Jose-WaitNRest/PCB-Cuarto/PCB/PCB-Cuarto.kicad_pcb

## KiCad design PCB/PCB-Cuarto.kicad_pcb (2026-04-22)

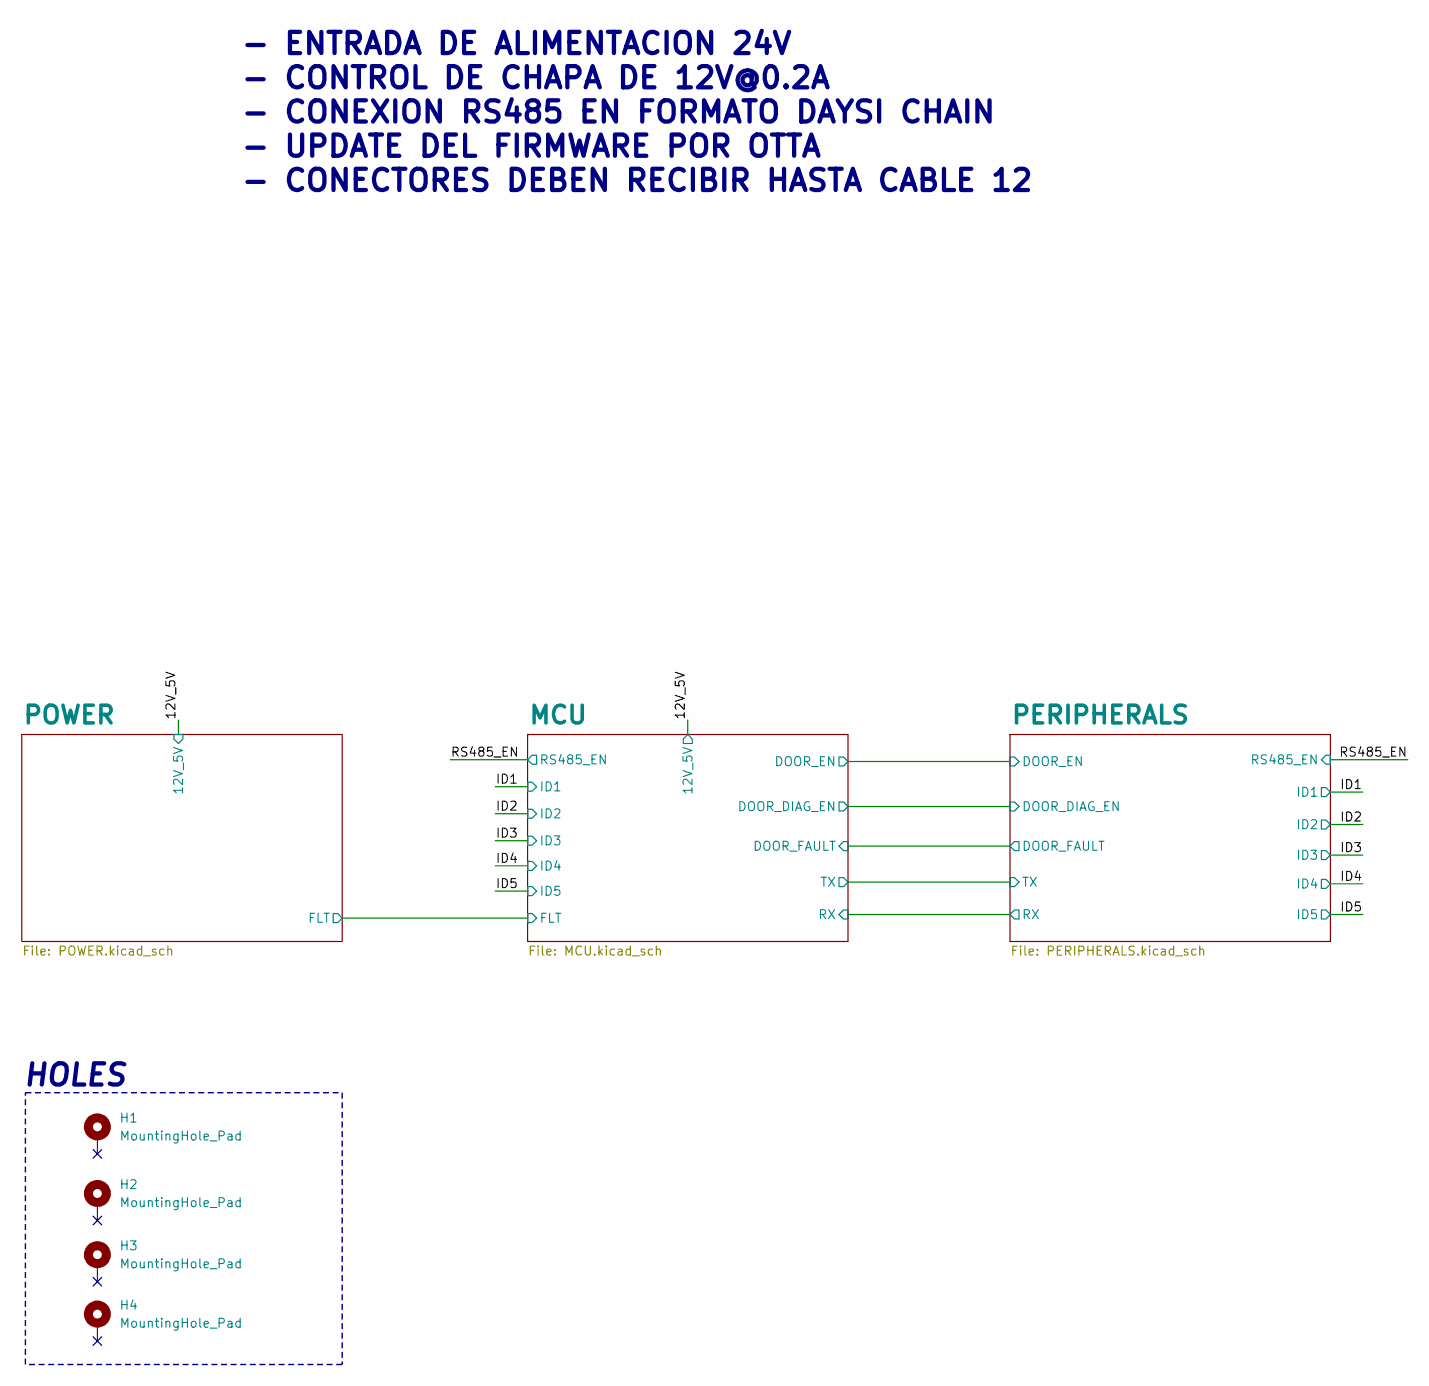
[picture p1: schematic PCB-Cuarto.kicad_sch]

Parts:
H1, H2, H3, H4: MountingHole_Pad; MountingHole_3.5mm_Pad_Via

Notes on the sheet:
- ENTRADA DE ALIMENTACION 24V - CONTROL DE CHAPA DE 12V@0.2A - CONEXION RS485 EN FORMATO DAYSI CHAIN - UPDATE DEL FIRMWARE POR OTTA - CONECTORES DEBEN RECIBIR HASTA CABLE 12
HOLES

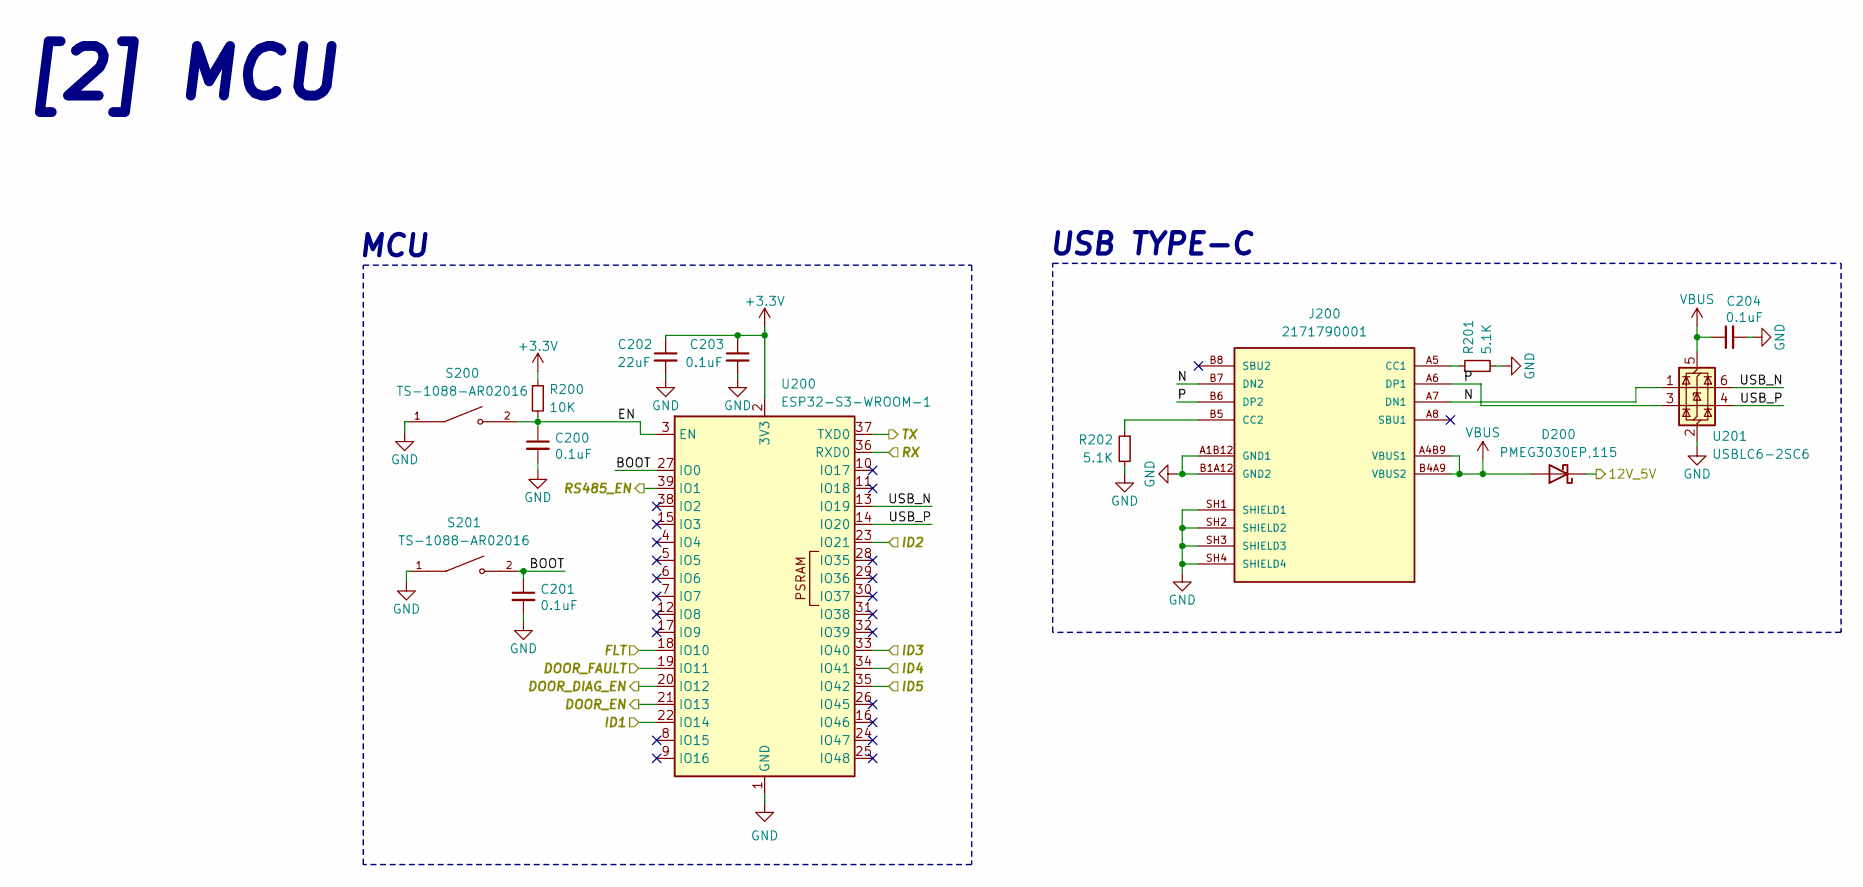
[picture p2: schematic MCU.kicad_sch]

Parts:
C200, C201, C203, C204: 0.1uF; C_0603_1608Metric_Pad1.08x0.95mm_HandSolder; LCSC C14663
C202: 22uF; C_0603_1608Metric_Pad1.08x0.95mm_HandSolder; LCSC C86295
D200: PMEG3030EP,115; D_SOD-128; LCSC C255587
J200: 2171790001; MOLEX_2171790001; LCSC C3197684
R200: 10K; R_0603_1608Metric; LCSC C25804
R201, R202: 5.1K; R_0603_1608Metric; LCSC C23186
S200, S201: TS-1088-AR02016; LCSC C720477
U200: ESP32-S3-WROOM-1; LCSC C2913202
U201: USBLC6-2SC6; SOT-23-6

Connections:
+3.3V: C202.1, C203.1, R200.1, U200.2 (3V3); also elsewhere on the board
/12V_5V: D200.1 (K); also elsewhere on the board
/ID1: U200.22 (IO14); also elsewhere on the board
/ID2: U200.23 (IO21); also elsewhere on the board
/ID3: U200.33 (IO40); also elsewhere on the board
/ID4: U200.34 (IO41); also elsewhere on the board
/ID5: U200.35 (IO42); also elsewhere on the board
/MCU/BOOT: C201.1, S201.2, U200.27 (IO0)
/MCU/DOOR_DIAG_EN: U200.20 (IO12); also elsewhere on the board
/MCU/DOOR_EN: U200.21 (IO13); also elsewhere on the board
/MCU/DOOR_FAULT: U200.19 (IO11); also elsewhere on the board
/MCU/EN: C200.1, R200.2, S200.2, U200.3 (EN)
/MCU/FLT: U200.18 (IO10); also elsewhere on the board
/MCU/N: J200.A7 (DN1), J200.B7 (DN2), U201.1 (I/O1)
/MCU/P: J200.A6 (DP1), J200.B6 (DP2), U201.3 (I/O2)
/MCU/RX: U200.36 (RXD0); also elsewhere on the board
/MCU/TX: U200.37 (TXD0); also elsewhere on the board
/MCU/USB_N: U200.13 (IO19), U201.6 (I/O1)
/MCU/USB_P: U200.14 (IO20), U201.4 (I/O2)
/RS485_EN: U200.39 (IO1); also elsewhere on the board
GND: C200.2, C201.2, C202.2, C203.2, C204.2, J200.A1B12 (GND1), J200.B1A12 (GND2), J200.SH1 (SHIELD1), J200.SH2 (SHIELD2), J200.SH3 (SHIELD3), J200.SH4 (SHIELD4), R201.2, R202.2, S200.1, S201.1, U200.1 (GND), U200.40 (GND), U200.41 (GND), U201.2 (GND); also elsewhere on the board
unnamed: J200.A5 (CC1), R201.1
unnamed: J200.B5 (CC2), R202.1
VBUS: C204.1, D200.2 (A), J200.A4B9 (VBUS1), J200.B4A9 (VBUS2), U201.5 (VBUS)

Notes on the sheet:
USB TYPE-C
[2] MCU
MCU

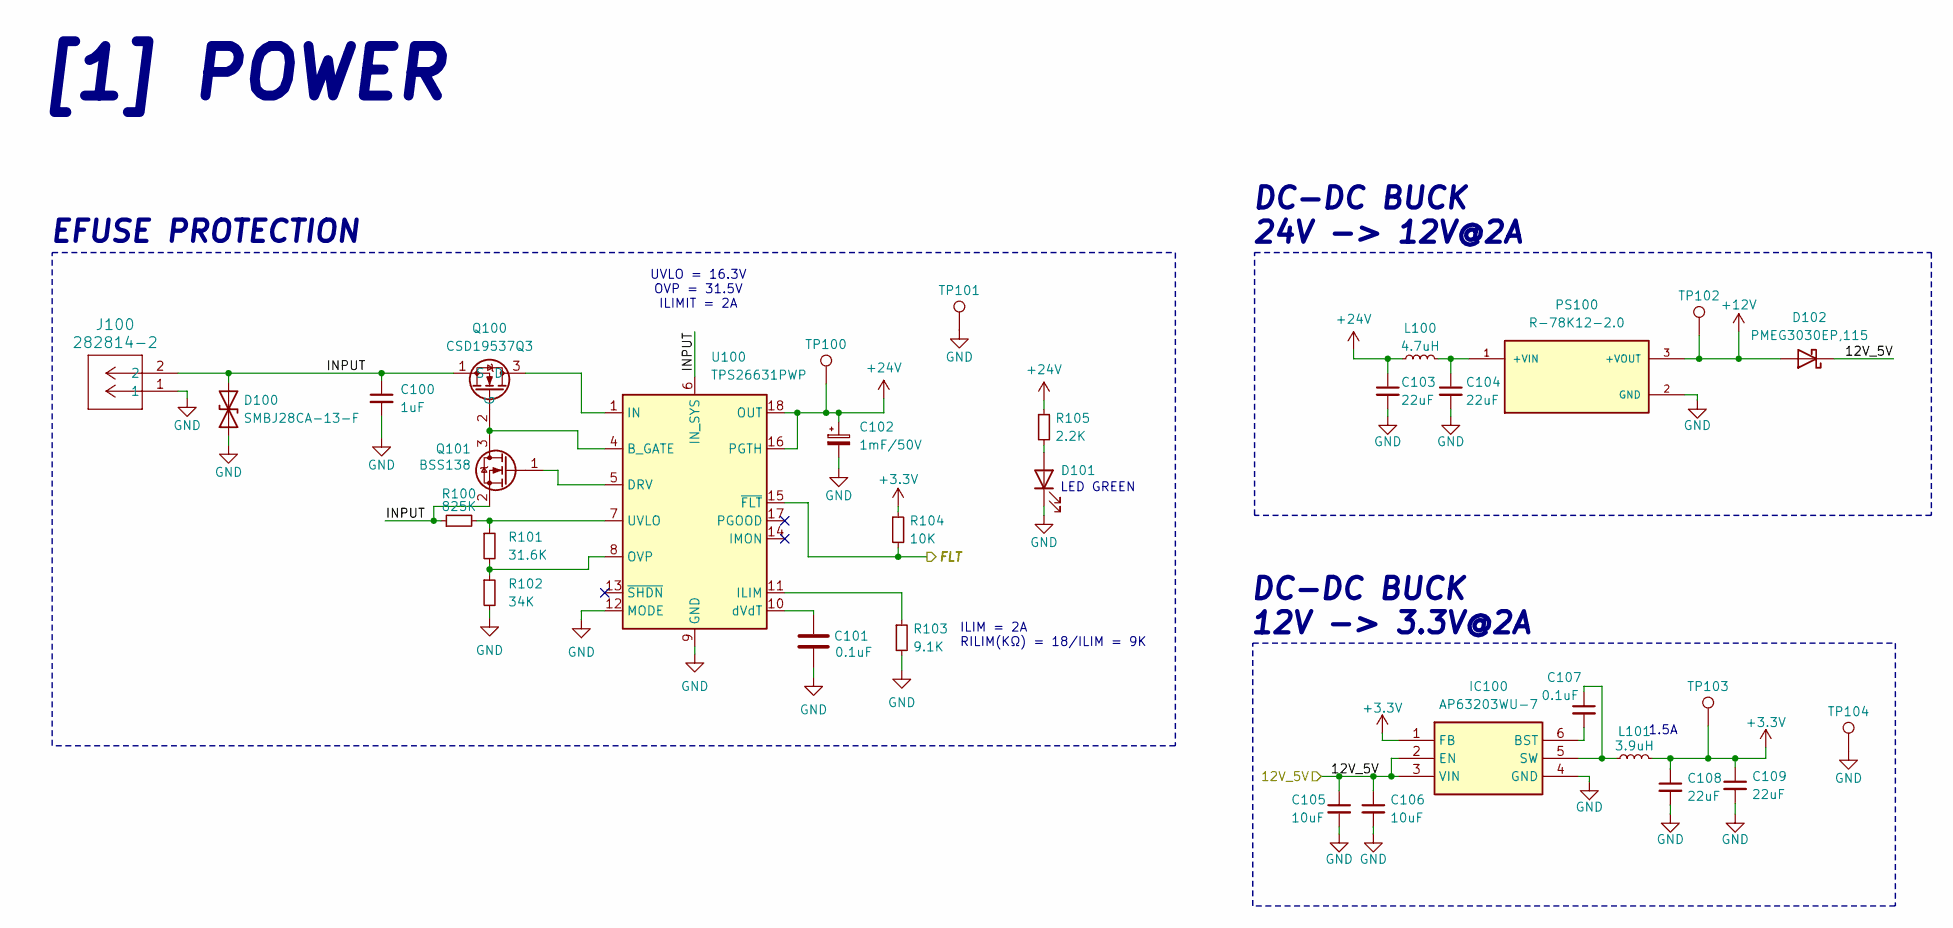
[picture p3: schematic POWER.kicad_sch]

Parts:
C100: 1uF; C_1206_3216Metric_Pad1.33x1.80mm_HandSolder; LCSC C1848
C101: 0.1uF; C_0603_1608Metric; LCSC C14663
C102: 1mF/50V; VKMI1701H102MV; LCSC C487374
C103, C104: 22uF; C_1206_3216Metric; LCSC C342620
C105, C106: 10uF; C_0805_2012Metric_Pad1.18x1.45mm_HandSolder; LCSC C440198
C107: 0.1uF; C_0603_1608Metric_Pad1.08x0.95mm_HandSolder; LCSC C14663
C108, C109: 22uF; C_0603_1608Metric_Pad1.08x0.95mm_HandSolder; LCSC C86295
D100: SMBJ28CA-13-F; D_SMB; LCSC C135064
D101: 19-21/GHC-YR1S2/4T; LED_0603_1608Metric; LCSC C2986048
D102: PMEG3030EP,115; D_SOD-128; LCSC C255587
IC100: AP63203WU-7; AP63203WU7; LCSC C780769
J100: 282814-2; LCSC C5187973
L100: 4.7uH; MDA5030-4R7M; LCSC C2847477
L101: 3.9uH; L_Sunlord_SWPA4030S; LCSC C96899
PS100: R-78K12-2.0; R-78K12-2_0; PARTREV 0/2023
Q100: CSD19537Q3; Mouser Part Number 595-CSD19537Q3
Q101: BSS138; SOT-23; LCSC C40912
R100: 825K; R_0805_2012Metric; LCSC C49010125
R101: 31.6K; R_0603_1608Metric; LCSC C25967
R102: 34K; R_0603_1608Metric; LCSC C23008
R103: 9.1K; R_0603_1608Metric; LCSC C23260
R104: 10K; R_0603_1608Metric; LCSC C25804
R105: 2.2K; R_0603_1608Metric; LCSC C4190
TP100, TP101, TP102, TP103, TP104: TestPoint; TestPoint_Pad_D2.0mm
U100: TPS26631PWP; HTSSOP-20-1EP_4.4x6.5mm_P0.65mm_EP3.4x6.5mm_Mask2.96x2.96mm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; LCSC C2832195

Connections:
+3.3V: C108.1, C109.1, IC100.1 (FB), L101.2, R104.1, TP103.1; also elsewhere on the board
+12V: D102.2 (A), PS100.3 (+VOUT), TP102.1; also elsewhere on the board
+24V: C102.1, C103.1, L100.1, R105.1, TP100.1, U100.16 (PGTH), U100.18 (OUT), U100.19 (OUT), U100.20 (OUT)
/12V_5V: C105.1, C106.1, D102.1 (K), IC100.2 (EN), IC100.3 (VIN); also elsewhere on the board
/MCU/FLT: R104.2, U100.15 (~FLT); also elsewhere on the board
/POWER/INPUT: C100.1, D100.2 (A2), J100.2, Q100.1 (S), Q101.2 (S), R100.1, U100.6 (IN_SYS)
GND: C100.2, C101.1, C102.2, C103.2, C104.2, C105.2, C106.2, C108.2, C109.2, D100.1 (A1), D101.1 (K), IC100.4 (GND), J100.1, PS100.2 (GND), R102.2, R103.2, TP101.1, TP104.1, U100.9 (GND), U100.12 (MODE), U100.21 (GND); also elsewhere on the board
unnamed: D101.2 (A), R105.2
unnamed: C107.2, IC100.6 (BST)
unnamed: C107.1, IC100.5 (SW), L101.1
unnamed: C104.1, L100.2, PS100.1 (+VIN)
unnamed: Q100.3 (D), U100.1 (IN), U100.2 (IN), U100.3 (IN)
unnamed: Q100.2 (G), Q101.3 (D), U100.4 (B_GATE)
unnamed: Q101.1 (G), U100.5 (DRV)
unnamed: R103.1, U100.11 (ILIM)
unnamed: R101.2, R102.1, U100.8 (OVP)
unnamed: R100.2, R101.1, U100.7 (UVLO)
unnamed: C101.2, U100.10 (dVdT)

Notes on the sheet:
[1] POWER
DC-DC BUCK 24V -> 12V@2A
DC-DC BUCK 12V -> 3.3V@2A
LED GREEN
UVLO = 16.3V OVP = 31.5V ILIMIT = 2A
EFUSE PROTECTION
ILIM = 2A RILIM(KΩ) = 18/ILIM = 9K
1.5A

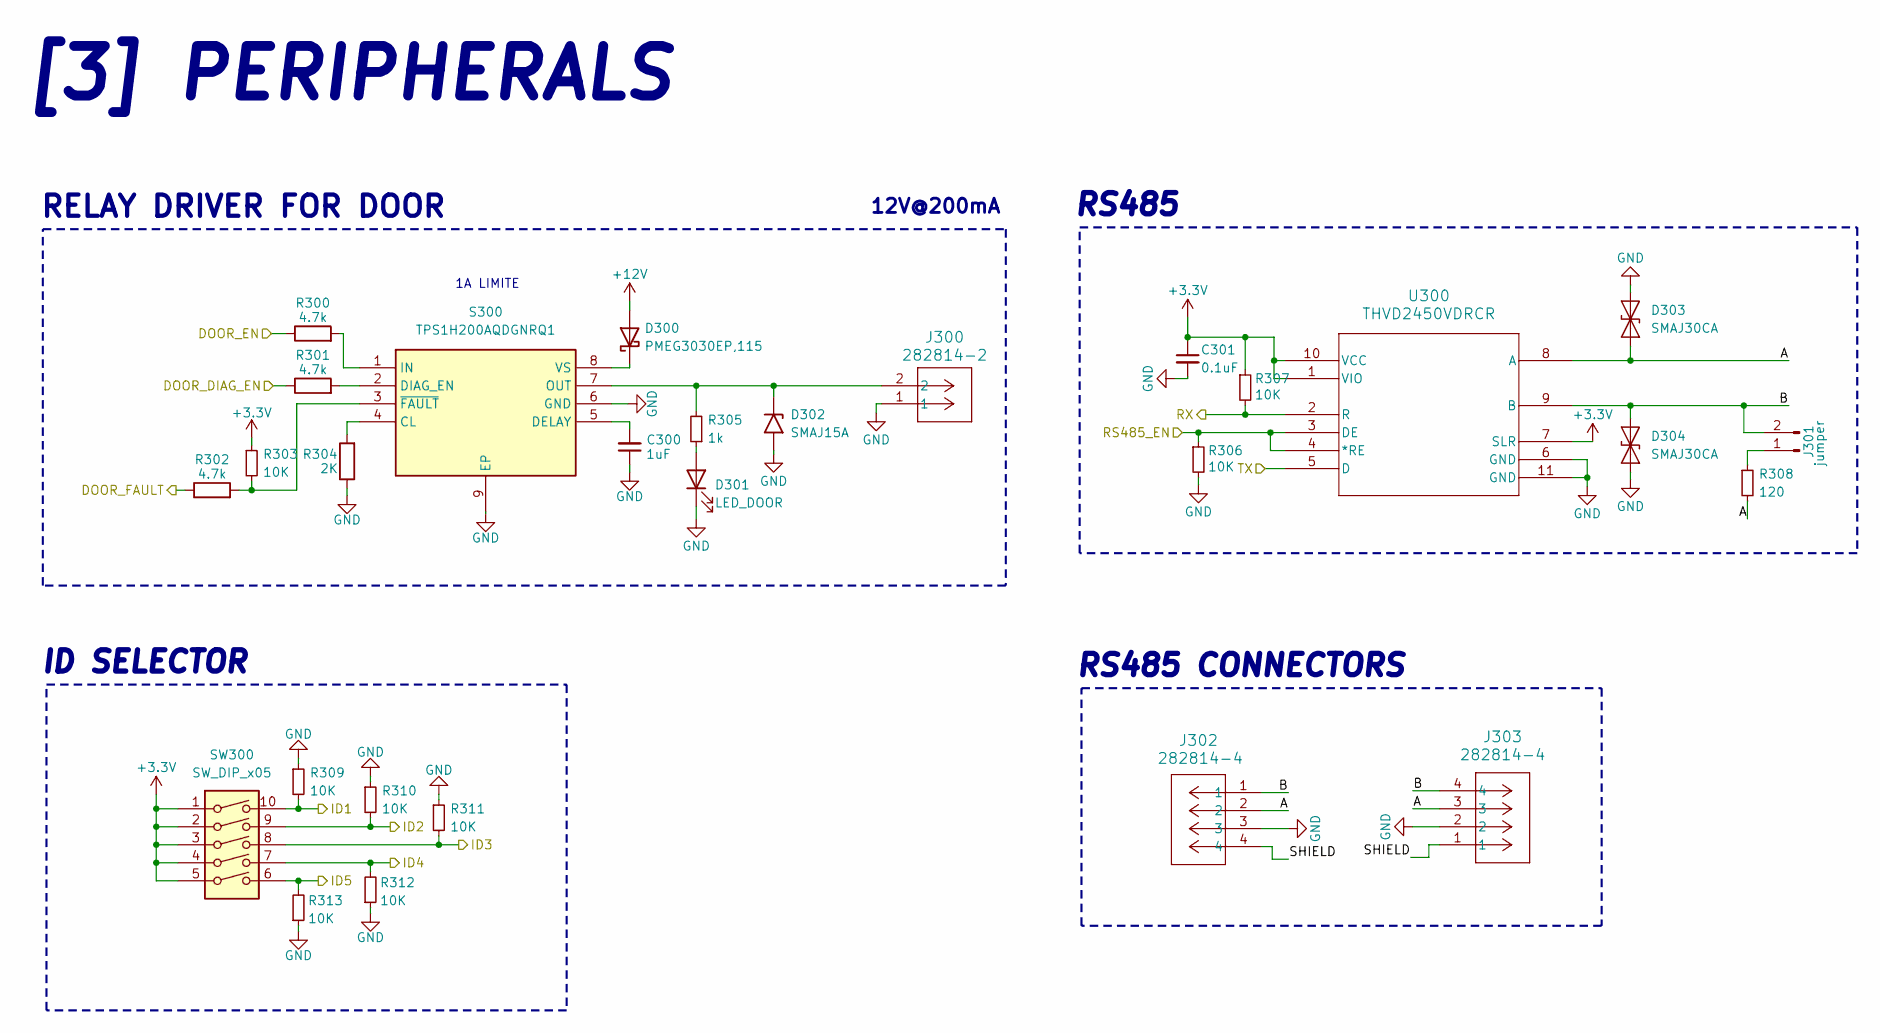
[picture p4: schematic PERIPHERALS.kicad_sch]

Parts:
C300: 1uF; C_0603_1608Metric_Pad1.08x0.95mm_HandSolder; LCSC C15849
C301: 0.1uF; C_0603_1608Metric; LCSC C14663
D300: PMEG3030EP,115; D_SOD-128; LCSC C255587
D301: LED_DOOR; LED_0603_1608Metric; LCSC C72038
D302: SMAJ15A; D_SMA; LCSC C110520
D303, D304: SMAJ30CA; D_SMA; LCSC C83322
J300: 282814-2; LCSC C5187973
J301: jumper; PinHeader_1x02_P2.54mm_Vertical; LCSC C492401
J302, J303: 282814-4; LCSC C5187975
R300, R301, R302: 4.7k; R_0603_1608Metric; LCSC C23162
R303, R306, R307, R309, R310, R311, R312, R313: 10K; R_0603_1608Metric; LCSC C25804
R304: 2K; R_0603_1608Metric; LCSC C22975
R305: 1k; R_0603_1608Metric; LCSC C21190
R308: 120; R_0603_1608Metric; LCSC C22787
S300: TPS1H200AQDGNRQ1; SOP65P490X110-9N; LCSC C2653785
SW300: SW_DIP_x05; DSIC-05-LS-GER; LCSC C7471367
U300: THVD2450VDRCR; VSON10_DRC_TEX; LCSC C5960705

Connections:
+3.3V: C301.1, R303.1, R307.1, SW300.1, SW300.2, SW300.3, SW300.4, SW300.5, U300.1 (VIO), U300.7 (SLR), U300.10 (VCC); also elsewhere on the board
+12V: D300.2 (A); also elsewhere on the board
/ID1: R309.2, SW300.10; also elsewhere on the board
/ID2: R310.2, SW300.9; also elsewhere on the board
/ID3: R311.2, SW300.8; also elsewhere on the board
/ID4: R312.2, SW300.7; also elsewhere on the board
/ID5: R313.2, SW300.6; also elsewhere on the board
/MCU/DOOR_DIAG_EN: R301.1; also elsewhere on the board
/MCU/DOOR_EN: R300.1; also elsewhere on the board
/MCU/DOOR_FAULT: R302.1; also elsewhere on the board
/MCU/RX: R307.2, U300.2 (R); also elsewhere on the board
/MCU/TX: U300.5 (D); also elsewhere on the board
/PERIPHERALS/A: D303.2 (A2), J302.2, J303.3, R308.2, U300.8 (A)
/PERIPHERALS/B: D304.2 (A2), J301.2, J302.1, J303.4, U300.9 (B)
/PERIPHERALS/SHIELD: J302.4, J303.1
/RS485_EN: R306.1, U300.3 (DE), U300.4 (*RE); also elsewhere on the board
GND: C300.1, C301.2, D301.1 (K), D302.2 (A2), D303.1 (A1), D304.1 (A1), J300.1, J302.3, J303.2, R304.1, R306.2, R309.1, R310.1, R311.1, R312.1, R313.1, S300.6 (GND), S300.9 (EP), U300.6 (GND), U300.11 (GND); also elsewhere on the board
unnamed: D300.1 (K), S300.8 (VS)
unnamed: D301.2 (A), R305.1
unnamed: D302.1 (A1), J300.2, R305.2, S300.7 (OUT)
unnamed: J301.1, R308.1
unnamed: R304.2, S300.4 (CL)
unnamed: C300.2, S300.5 (DELAY)
unnamed: R301.2, S300.2 (DIAG_EN)
unnamed: R300.2, S300.1 (IN)
unnamed: R302.2, R303.2, S300.3 (~FAULT)

Notes on the sheet:
ID SELECTOR
RS485 CONNECTORS
RELAY DRIVER FOR DOOR
[3] PERIPHERALS
1A LIMITE
12V@200mA
RS485

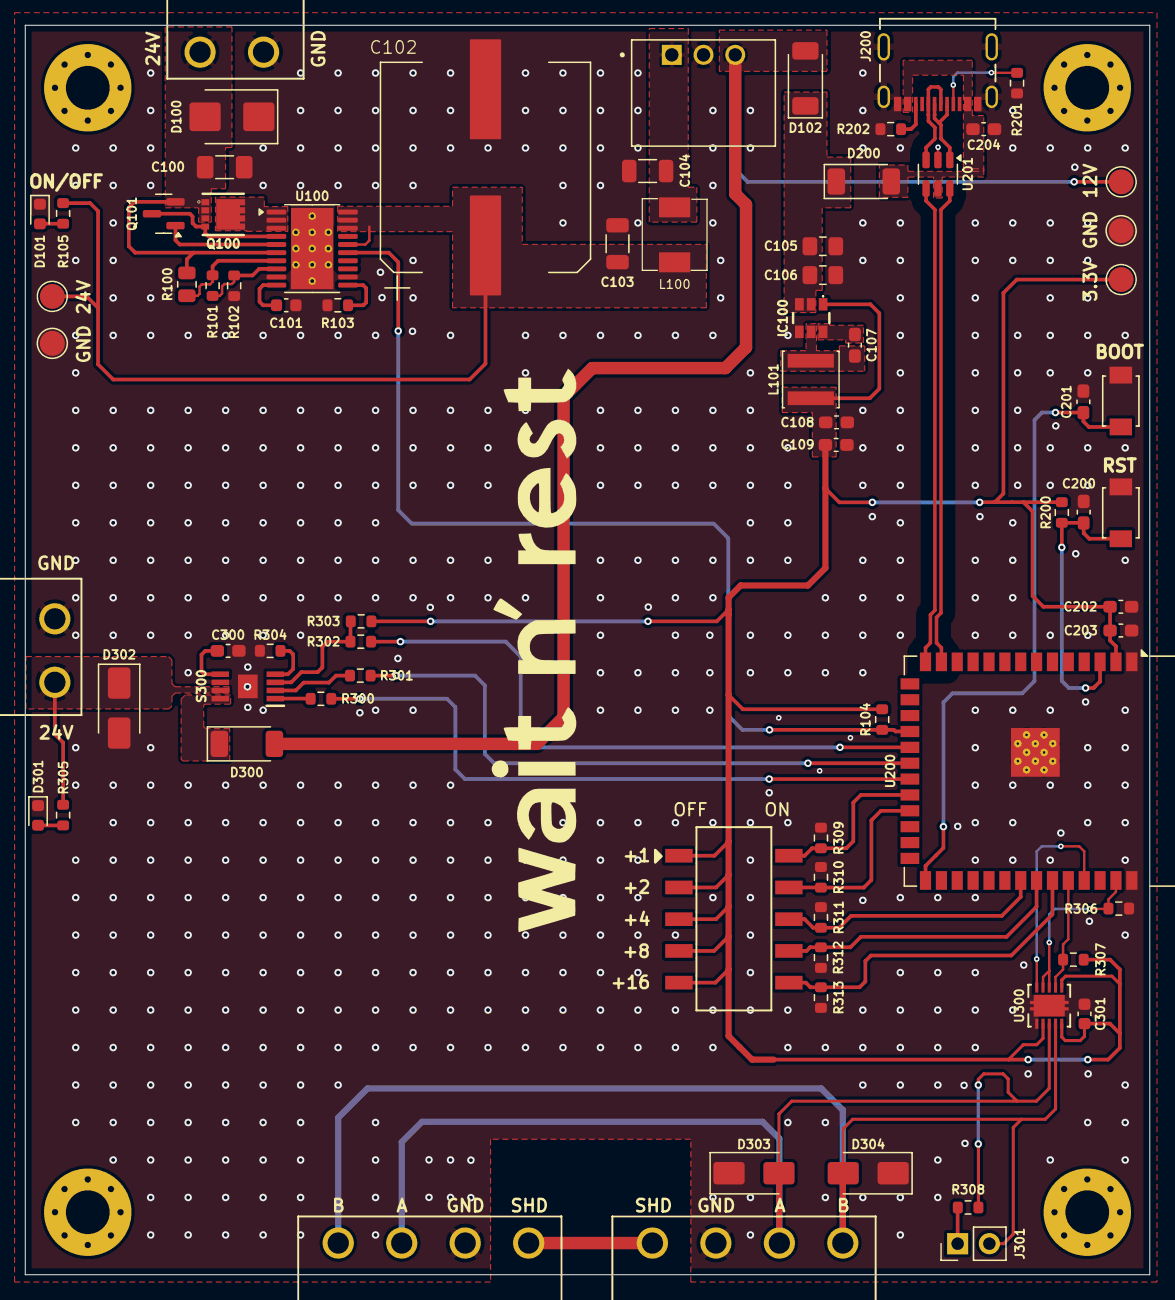
[picture p5: board PCB-Cuarto.kicad_pcb from above]

Board: 4 copper layers, 90.0 x 100.0 mm, 78 parts (0 on the bottom side), 50 nets.
