Jose-WaitNRest/PCB-Cuarto/(commit log)

2026-03-04 Creación del ecosistema de trabajo
    Se creo el ecosistema de trabajo de la PCB y además, el file KICAD de la PCB
    [PCB-Cuarto.kicad_pcb, PCB-Cuarto.kicad_sch]
2026-03-05 Implementacion del eFuse
    Se hizo el diseño esquematico del eFuse
    [MCU.kicad_sch, PCB-Cuarto.kicad_sch, PERIPHERALS.kicad_sch, POWER.kicad_sch]
2026-03-05 Diseño DC-DC
    Se diseño las 2 etapas DC-DC:
    - 24V a 12V con filtros
    - 12V a 3.3V
    [POWER.kicad_sch]
2026-03-05 Diseño MCU ESP32-S3 y USB-C conector
    Se diseño el ESP32-S3-WROOM-1 junto a su conector USB-C para flashear el MCU
    [MCU.kicad_sch, PCB-Cuarto.kicad_sch]
2026-03-08 Agregado RS485, Smart Switch, ORING Diode
    Se termino de acabar todo el esquematico, solo falta crear el footprint para un inductor
    [MCU.kicad_sch, PCB-Cuarto.kicad_sch, PERIPHERALS.kicad_sch, POWER.kicad_sch]
2026-03-10 Placement
    Se termino de crear el footprint para el inductor y placement en la PCB
    [MCU.kicad_sch, PCB-Cuarto.kicad_pcb, PCB-Cuarto.kicad_sch, PERIPHERALS.kicad_sch, POWER.kicad_sch]
2026-03-16 PCB acabada con labels
    Se agrego:
    - Planos de tierra
    - Stitching vias
    - Labels indicadores para todo los conectores
    Se corrigio:
    - Errores de librerias de footprint - TPS26631RGE
    - Pines sin conectarse
    [MCU.kicad_sch, PCB-Cuarto.kicad_pcb, POWER.kicad_sch]
2026-03-16 Edicion de archivos para JLCPCB
    Se ha realizado:
    - Cambio de footprint de capacitor 1mF
    - Edicion de algunos value references
    - Creación de archivos para JLCPCB
    [MCU.kicad_sch, PCB-Cuarto.kicad_pcb, POWER.kicad_sch, bom.csv, designators.csv, positions - Copy.csv, positions.csv]
2026-03-18 Fix label conector RS485
    El label del conector RS485 estaba erroneo, se tuvo que cambiar las posiciones
    [PCB-Cuarto.kicad_pcb]
2026-04-05 Mejora en ruteo
    - Se ha mejorado el ruteo de potencia
    - Se ha generado los files para JLCPCB
    [PCB-Cuarto.kicad_pcb, PERIPHERALS.kicad_sch, positions - Copy.csv, positions.csv]
2026-04-06 Cambio de footprint del eFuse
    - Se cambio el footprint del eFuse debido a que el actual no hay stock en JLCPCB
    - Se creo de nuevo los archivos de configuracion de JLCPCB
    [PCB-Cuarto.kicad_pcb, POWER.kicad_sch, bom.csv, positions - Copy.csv, positions.csv]
2026-04-07 Fix Stitching Vias y Clearance USB trace
    * Se eliminaron las vías que se encontraban demasiado cercanas a componentes o a ciertas zonas, lo cual representaba un problema común generado por el uso de *stitching vias*.
    * Se definió un *clearance* de 0.8 mm para las pistas USB, con el fin de respetar el cálculo de impedancia bajo una configuración *no coplanar*. Esto se debe a que, al estar la PCB completamente rodeada por GND, el par diferencial USB pasaba a comportarse como coplanar. Solo se considera no coplanar cuando existe una separación mínima de tres veces el ancho de la pista (0.286 mm), es decir, aproximadamente 0.8 mm. Esta condición se implementó mediante el uso de *Custom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
2026-04-07 fix gitignore
    [PCB-Cuarto.kicad_pcb]
2026-04-22 Change Placement
    Se ha cambiado el placement total para obtener una mejor posicion de conexion de los perifericos
    [MCU.kicad_sch, PCB-Cuarto.kicad_pcb, PERIPHERALS.kicad_sch, POWER.kicad_sch]
